davidegironi/avr-industrialweightchecker-t01/README

==================================================
AVR Industrial weight checker - Type 01
==================================================
= Copyright (c) Davide Gironi, 2021              =
= http://davidegironi.blogspot.it/               =
==================================================

Industrial weight checker - Type 01
Checks weight difference between current and previous weight
and possibly trigger an alter.

Devel Notes
-----------
Developed on VSCode + platform.io, built with avr-gcc on Atmega8 @ 8MHz.

License
-------
Please refer to LICENSE file for licensing information.
