davidegironi/avr-industrialweightchecker-t01/schematics/avr_industrialweightchecker-t01_01.png

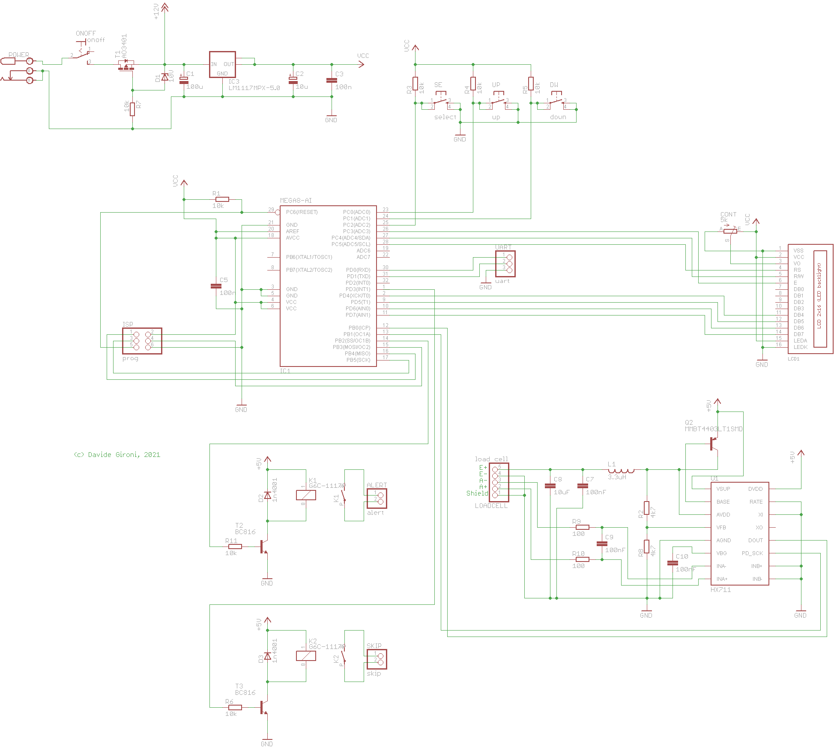
schematics/avr_industrialweightchecker-t01_01.png
