davidegironi/avr-industrialweightchecker-t01/schematics/avr_industrialweightchecker-t01_01.sch

## EAGLE design schematics/avr_industrialweightchecker-t01_01.sch (2021-02-08)

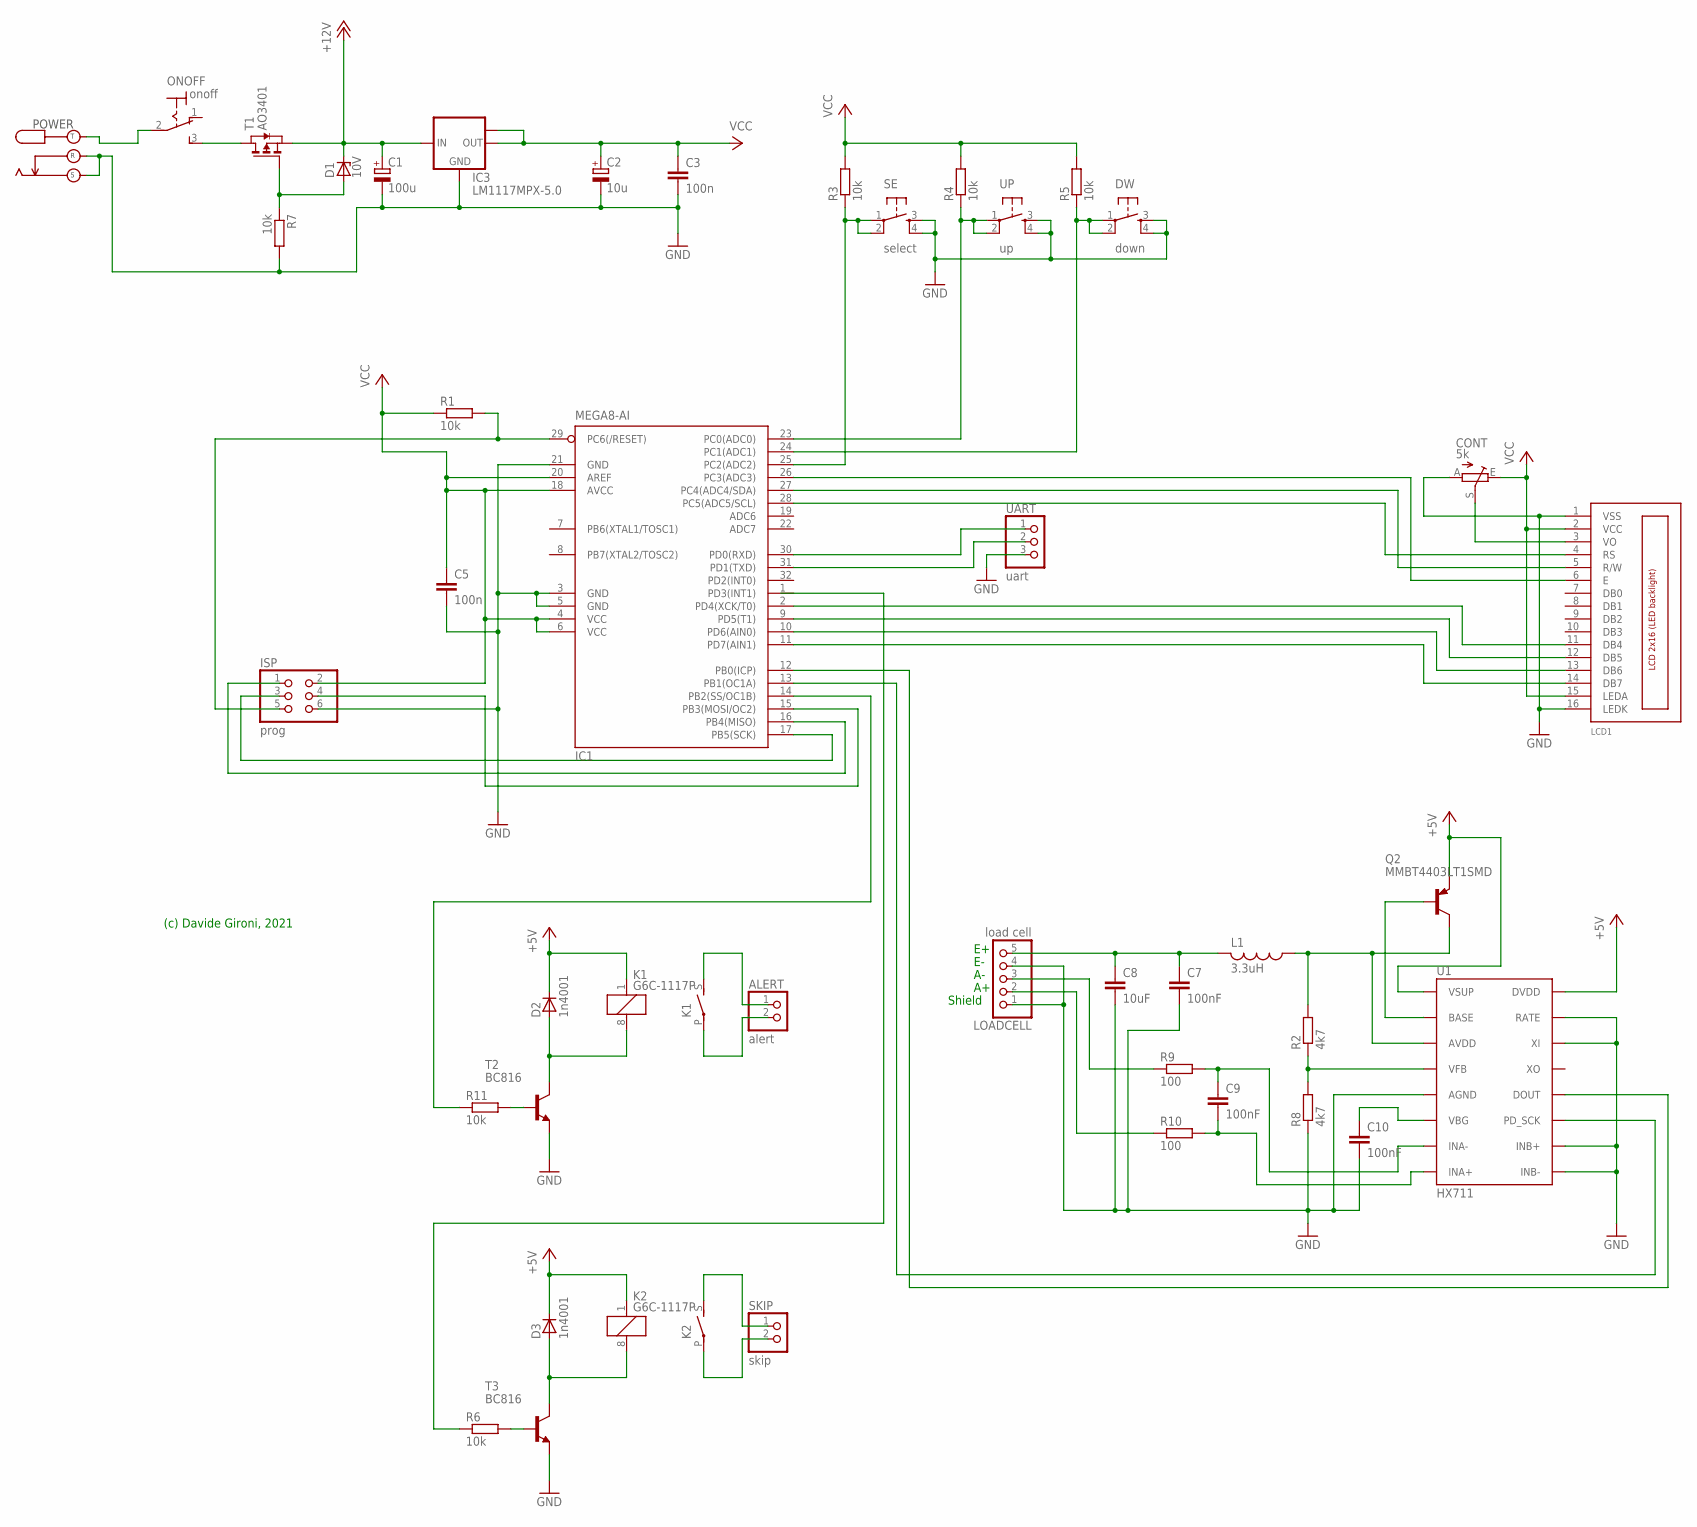
[picture p2: schematic avr_industrialweightchecker-t01_01.sch]

Parts:
ALERT: alert; 1X02
C1: 100u; UD-6,3X7,7_NICHICON
C2: 10u; B/3528-21R
C3, C5: 100n; C0805
C7, C9, C10: 100nF; C0805
C8: 10uF; C0805
CONT: 5k; B25P
D1: 10V; SOD80C
D2, D3: 1n4001; SOD80
DW: down; TACTILE-PTH
IC1: MEGA8-AI; TQFP32-08
IC3: LM1117MPX-5.0; SOT223
ISP: prog; 2X03
K1, K2: G6C-1117P
L1: 3.3uH; L4532M
LCD1: LCD_2X16_SIL; HY-1602F
LOADCELL: load cell; 1X05
ONOFF: onoff; M9040P
POWER: power; DC_VERT
Q2: MMBT4403LT1SMD; SOT23-BEC
R1, R3, R4, R5, R7: 10k; R0805
R2, R8: 4k7; R0603
R6, R11: 10k; R0603
R9, R10: 100; R0603
SE: select; TACTILE-PTH
SKIP: skip; 1X02
T1: AO3401; SOT-23
T2, T3: BC816; SOT23-EBC
U1: HX711; SO16
UART: uart; 1X03
UP: up; TACTILE-PTH

Connections:
+5V: D2.1 (C), D3.1 (C), K1.1, K2.1, Q2.E, U1.1 (VSUP), U1.16 (DVDD)
+12V: C1.+, D1.C, IC3.3 (IN), T1.2 (S)
GND: C1.-, C2.-, C3.2, C5.2, C7.2, C8.2, C10.2, CONT.A, DW.3, DW.4, IC1.3 (GND), IC1.5 (GND), IC1.21 (GND), IC3.1 (GND), ISP.6, LCD1.1 (VSS), LCD1.16 (LEDK), LOADCELL.1, LOADCELL.4, POWER.R, POWER.S, R7.2, R8.1, SE.3, SE.4, T2.E, T3.E, U1.5 (AGND), U1.9 (INB-), U1.10 (INB+), U1.14 (XI), U1.15 (RATE), UART.3, UP.3, UP.4
unnamed: CONT.S, LCD1.3 (VO)
unnamed: R6.2, T3.B
unnamed: ONOFF.3 (S), T1.1 (D)
unnamed: IC1.10 (PD6(AIN0)), LCD1.13 (DB6)
unnamed: IC1.11 (PD7(AIN1)), LCD1.14 (DB7)
unnamed: D3.2 (A), K2.8 (2), T3.C
unnamed: L1.1, Q2.C, R2.2, U1.3 (AVDD)
unnamed: Q2.B, U1.2 (BASE)
unnamed: R2.1, R8.2, U1.4 (VFB)
unnamed: IC1.9 (PD5(T1)), LCD1.12 (DB5)
unnamed: IC1.2 (PD4(XCK/T0)), LCD1.11 (DB4)
unnamed: ONOFF.2, POWER.T
unnamed: IC1.23 (PC0(ADC0)), R4.1, UP.1, UP.2
unnamed: IC1.25 (PC2(ADC2)), R3.1, SE.1, SE.2
unnamed: IC1.29 (PC6(/RESET)), ISP.5, R1.2
unnamed: DW.1, DW.2, IC1.24 (PC1(ADC1)), R5.1
unnamed: C7.1, C8.1, L1.2, LOADCELL.5
unnamed: C10.1, U1.6 (VBG)
unnamed: IC1.30 (PD0(RXD)), UART.1
unnamed: IC1.16 (PB4(MISO)), ISP.1
unnamed: IC1.17 (PB5(SCK)), ISP.3
unnamed: D1.A, R7.1, T1.3 (G)
unnamed: C9.1, R9.2, U1.7 (INA-)
unnamed: C9.2, R10.2, U1.8 (INA+)
unnamed: LOADCELL.3, R9.1
unnamed: LOADCELL.2, R10.1
unnamed: IC1.13 (PB1(OC1A)), U1.11 (PD_SCK)
unnamed: IC1.31 (PD1(TXD)), UART.2
unnamed: IC1.12 (PB0(ICP)), U1.12 (DOUT)
unnamed: R11.2, T2.B
unnamed: IC1.26 (PC3(ADC3)), LCD1.6 (E)
unnamed: IC1.27 (PC4(ADC4/SDA)), LCD1.5 (R/W)
unnamed: D2.2 (A), K1.8 (2), T2.C
unnamed: IC1.28 (PC5(ADC5/SCL)), LCD1.4 (RS)
unnamed: ALERT.2, K1.P
unnamed: IC1.14 (PB2(SS/OC1B)), R11.1
unnamed: K2.P, SKIP.2
unnamed: ALERT.1, K1.S
unnamed: K2.S, SKIP.1
unnamed: IC1.15 (PB3(MOSI/OC2)), ISP.4
VCC: C2.+, C3.1, C5.1, CONT.E, IC1.4 (VCC), IC1.6 (VCC), IC1.18 (AVCC), IC1.20 (AREF), IC3.2 (OUT), IC3.TAB (OUT1), ISP.2, LCD1.2 (VCC), LCD1.15 (LEDA), R1.1, R3.2, R4.2, R5.2

Notes on the sheet:
(c) Davide Gironi, 2021
Shield
