davidegironi/avr-industrialweightchecker-t01/docs/EN_manual.docx

Industrial Weight Checker – Type 01 – v1.0

Buttons

- S: select
- <: up
- >: down

Work Modes:

- Calibration
- Configuration
- Running

Menu browsing:

- To enter Calibration long press S on boot
- To enter Configuration long press S during Running mode
- To save settings long press S on Calibration or Running mode
- In menu Press S to skip to next mode
- Press < or > to change the values

Configuration Menu

- Interval: times between weights (sec)
- Num Errors: number of error to wait for an Alert to be triggered
- Diff Error: threshold difference between current and previous weight to trigger and error
- Tare: set tare, long press < to set
- Alert Enabled: enable or disable the Alert triggering
- Skip Interval: skip timer activation time (min), 0 to disable
- Skip Time: skip time (min)

Calibration Menu

- Cal. Gain: weight sensor gain
- Cal. Offset: weight sensor offset/tare, leave the scale empty and long press < to set
- Cal. Weight: reference wieght for calibration
- Cal Scale: weight sensor scale, put the Cal Weight on the scale, long press < to set

Running mode:

- Press < to view the remaining time till the next skip
- On Alert, long press > to reset
