davidegironi/avr-industrialweightchecker-t01/(commit log)

2021-02-19 folder and naming updates
    [avr_industrialweightchecker-t01_01.sch]
2021-02-20 added schematic image
